RonHeg/PostAlertBaseStationMFG/README.md

# PostAlertBaseStationMFG
 PostAlert IoT Base station Documentation for manufacturing
