RonHeg/PostAlertBaseStationMFG/PostAlertBaseStationMFG/README.md

# PostAlertBaseStationMFG
 PostAlert IoT Base station Documentation for manufacturing
 PCB Gerber files are in the gerber_to_order folder
 mechanical drawings are: light pipe, base unit enclosure cutouts, front panel, base station assembly
