RonHeg/PostAlertBaseStationMFG/012024-LBL.pdf

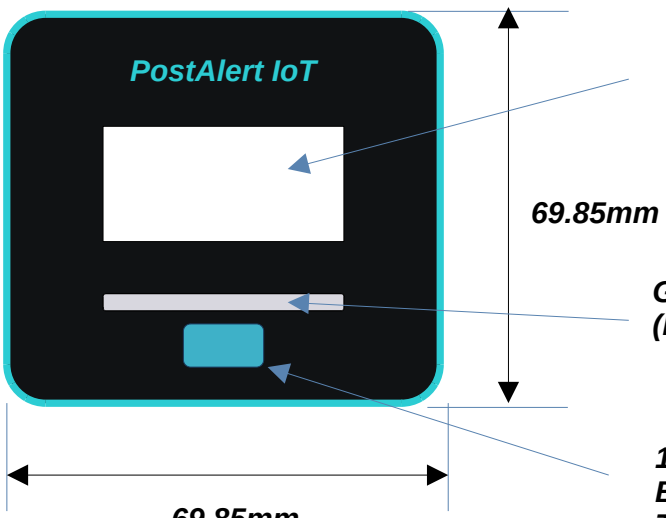
[picture p1: figure]
PostAlert IoT

Overlay attaches to top of :

New Age Enclosures: Standard Router Cube SXX-303010-XXX.

Notes:
Material: Glossy 0.2mm, PET

Transparent area: OLED display. The yellow part is a transparent clear window.

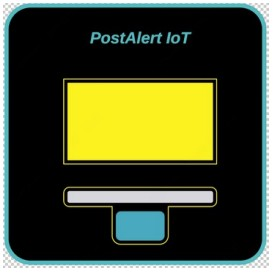
[picture p2: figure]

Grayed out area: 50% transparency. (Multi-colored LED for status)

Blacked out behind area: has a push switch mounted on the PCB.
Black out behind blue to keep out light from LED status.

Adhesive backing: 3M468MP.
These regions within yellow lines will have no adhesive on the Back of the panel.

The blue button is a flat-top bulged button with a height of 0.45mm.

Colors:
Aqua = Pantone 319 C (RGB 44, 204, 211 – HEX 2cccd3)
Black = Pantone 6C(RGB 16, 24, 32 – HEX 101803)
Gray = Pantone 5315 C (RGB 216, 215, 223 – HEX d8d7df)

Suggested Supplier:
LCSC Electronics (https://www.lcsc.com/)

RJ Hegler Technologies, LLC 9192 Albion Road
North Royalton, Ohio 44133 RJHeglerTech@gmail.com
Ron Hegler
440-478-1586

### PostAlert IoT Base Lable Drawing Number: 012024-LBL Revision 1.0

69.85mm

### Transparent (glossy) (OLED Display)

### Grayed out (Multi-color LED)

### 1 bulged button (height: 0.45mm) Blacked out behind To keep above LED from bleeding thru this area

### Note: Artwork in this drawing is for Reference only. Use MailBoxOverlay.odg for master

drawing.
