RonHeg/PostAlertBaseStationMFG/012024MainRegLabel.pdf

## PostAlert IoT Base Lable Drawing Number: 012024-LBL Revision 1.0

RJ Hegler Technologies, LLC 9192 Albion Road
North Royalton, Ohio 44133 RJHeglerTech@gmail.com
Ron Hegler
440-478-1586

RJ Hegler Technologies, LLC 9192 Albion Road
North Royalton, Ohio 44133 RJHeglerTech@gmail.com
Ron Hegler
440-478-1586

## Note: Artwork in this drawing is for Reference only. Actual text will be provided after

regulatory approval.

Label attaches to bottom of :

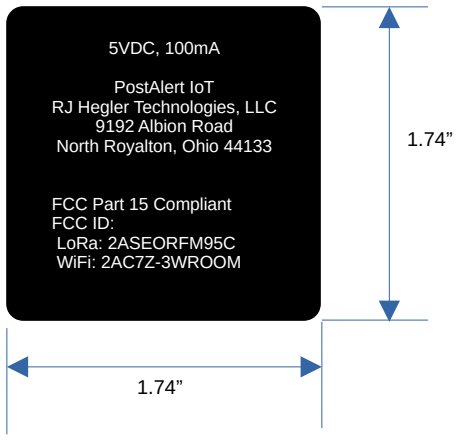
[picture p3: figure]
5VDC, 100mA; PostAlert IoT RJ Hegler Technologies, LLC 9192 Albion Road North Royalton, Ohio 44133; FCC Part 15 Compliant FCC ID: LoRa: 2ASEORFM95C WiFi: 2AC7Z-3WROOM

New Age Enclosures: Standard Router Cube SXX-303010-XXX.

Notes:
Material: Glossy 0.2mm, PET (Ref, subject to change)

Adhesive backing: 3M468MP.

### Colors

### Black = Pantone 6C (RGB 16, 24, 32 – HEX 101803) White =

### Suggested Supplier: LCSC Electronics (https://www.lcsc.com/)
