RonHeg/PostAlertBaseStationMFG/MailBoxOverlay.pdf

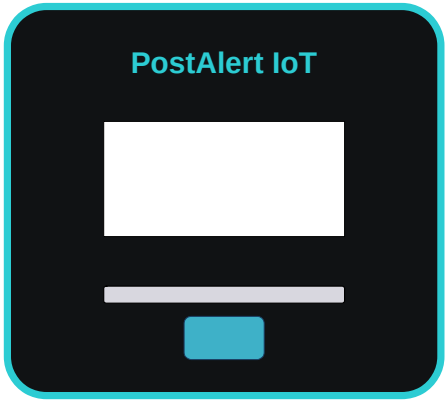
[picture p4: figure]
PostAlert IoT
