RonHeg/PostAlertBaseStationMFG/042024MainBoxAssyBOM.xls

PostAlert ToI main enclosure assembly
Item | Quantity | Description
1 | 1 | Main Enclosure Front Overlay
2 | 1 | Enclosure Front, modified
3 | 8 | M2 x 6 mm screws
4 | 1 | OLED Display
5 | 4 | M2 x 12 mm Brass Spacers
6 | 1 | Main Unit PCB Assembly
7 | 1 | Enclosure Back, modified
8 | 1 | Rear Label
9 | 4 | Screws included with enclosure
10 | 1 | PostAlert Base Light Pipe
11 | A/R | Adhesive
