RonHeg/PostAlertBaseStationMFG/PostAlertBaseStationV6.xls

Sheet: PostAlertBaseStationV6
PostAlert IoT Base Station Assy BOM
Source: | C:\RJHTech\Mailbox\PostAlertBaseStation\PostAlertBaseStationV6\PostAlertBaseStationV6.kicad_sch
Date: | 1/17/2025 12:04:40 PM
Tool: | Eeschema 7.0.10
Generator: | C:\Program Files\KiCad\7.0\bin\scripting\plugins/bom_csv_grouped_by_value.py
Component Count: | 43
Collated Components:
Item | Qty | Reference(s) | Value | Description | MFR | PN | Price(100s) | Supplier | Supplier_num
1 | REF | AE2 | Antenna | PCB Etch Antenna, 915MHz
2 | 1 | BZ1 | Piezo 3VDC 2300Hz 82dBA | Piezo Buzzers & Audio Indicators EM 3VDC 2300Hz 82dBA Continuous Top Fire | PUI Audio | AI-1223-TWT-3V-2-R | 0.817 | Mouser | 665-AI1223TWT3V2R
3 | 9 | C1, C5, C7, C9, C12, C13, C15, C16, C17 | 0.1uF | 50V .1uF X7R 0603 10% | KYOCERA AVX | KGM15BR71H104KT | 0.019 | Mouser | A581-06035C104KAT2A
4 | 5 | C2, C4, C6, C8, C10 | 10uf 6.3v | 6.3V 10uF X5R 0603 20% | KYOCERA AVX | KGM15CR50J106MT | 0.061 | Mouser | 581-KGM15CR50J106MT
5 | 1 | C3 | 11pF | MLCC - SMD/SMT 50V 11pF C0G 0603 5% | KYOCERA AVX | 06035A110JAT2A | 0.0232 | Mouser | 581-06035A110J
6 | 1 | C11 | 1uF, 16v | MLCC - SMD/SMT 16V 1uF X7R 0603 10 % | TAIYO YUDEN | MSASE168SB7105KTNA01 | 0.073 | Mouser | 963-MSASE168SB7105KT
7 | 1 | C19 | DNP | Multilayer Ceramic Capacitors MLCC - SMD/SMT 50V 1.6pF C0G 0603 0 .25pF | KYOCERA AVX | 06035A1R6CAT2A | 0.0232 | Digikey | 581-06035A1R6CAT2A
8 | 1 | D1 | NeoPixel_THT | NeoPixel Nano 2020 RGB LEDs - 10-pack - WS2812B | Adafruit | 4684 | 0.395 | Mouser | 485-4684
9 | 3 | D2, D3, D4 | 5v | ESD Protection Diodes / TVS Diodes Chip Guard 0603 5 Volts | Bourns | CG0603MLC-05LE | 0.164 | Mouser | 652-CG0603MLC-05LE
10 | 1 | DISP1 | 1.54" OLED | 1.54 Inch OLED I2C IIC Display Module, 128x64 Pixel SSD1309 Driver Self-Luminous OLED | MELIFE Store | 12864 | 6.63 | Amazon | 701715529748
11 | 1 | J1 | Conn_01x04_Socket | Headers & Wire Housings 4 PIN SIL VERTICAL SOCKET GOLD+TIN | Harwin | M20-7820442 | 0.65 | Mouser | 855-M20-7820442
12 | 1 | J2 | ESP-Prog | Connector Header Surface Mount 6 position 0.050" (1.27mm) | Amphenol ICC (FCI) | 20021121-00006C4LF | 0.4948 | Digikey | 609-3693-1-ND
13 | 1 | J5 | USB_B_Micro | CONN RCPT USB2.0 MICRO B SMD R/A | Amphenol ICC (FCI) | 10118192-0002LF | 0.3055 | Digikey | 609-5379-1-ND
14 | 1 | L1 | 36nH | FIXED IND 36NH 910MA 0.200OHM SMD | Murata | LQW18AN36NJ80D | $0.108 | Mouseer | 81-LQW18AN36NJ80D
15 | 1 | Q2 | MMBT3904 | TRANS NPN 40V 0.2A SOT23 | Micro Commercial Co | MMBT3904-TP | 0.0369 | Digikey | MMBT3904TPMSCT-ND
16 | 7 | R1, R2, R3, R4, R5, R6, R7 | 10k | Thin Film Resistors - SMD CHIP RESISTOR Precision | Bourns | CRT0603-FZ-1002ELF | 0.023 | Mouser | 652-CRT0603FZ1002ELF
17 | 1 | R8 | 8.2k | Thick Film Resistors - SMD D11/CRCW0603 100 8K2 1% | Vishay / Dale | CRCW06038K20FKEC | 0.014 | Mouser | 71-CRCW06038K20FKEC
18 | 1 | SW1 | SW_Push | Tactile Switches 6 x 6 mm, 7.3 mm Act Height, 160 gf, Black, Long Crimped, Through Hole, SPST, | CUI Devices | TS01-66-73-BK-160-D | 0.107 | Mouser | 179-TS016673BK160D
19 | 2 | SW2, SW3 | SW_Push | Tactile Switches 6 x 7.4 mm 4.3 mm 100 gf Black Right Angle Through Hole SPST | CUI Devices | TS11-674-43-BK-100-RA-D | 0.123 | Mouser | 179-TS1167443100RAD
20 | 1 | U1 | ESP32-C3 | RF TXRX MODULE BT PCB TRACE SMD | Espressif Systems | ESP32-C3-MINI-1-H4 | 1.9 | Digikey | 1965-ESP32-C3-MINI-1-H4TR-ND
21 | 1 | U2 | RFM95W-915S2 | RF TXRX MODULE ISM<1GHZ WIRE ANT | Hope RF | RFM95CW-915S2 / COM-18085 | 6.50 / 9.95 / 4.52 | Arduino.com / Sparkfun / Aliexpress | RFM95CW-915S2
22 | 1 | U3 | AZ1117-3.3 | LDO Voltage Regulators LDO BJT HiCurr | Diodes Incorporated | AZ1117H-3.3TRG1 | 0.781 | Mouser | 621-AZ1117H-3.3TRG1
* |  | Not Yet Evaluated | lora1276-C1-915MHz | G-NiceRF lora1276-C1-915MHz | https://www.lcsc.com/product-detail/LoRa-Modules_G-NiceRF-lora1276-C1-915MHz_C3001531.html

Sheet: Base Station Assy
Base Station Final
Item | Qty | Description | MFR | PN | Price(100s) | Supplier | Supplier_num
1 | 1 | Overlay, Front | DWG | 012021-OVL |  | LCSC
2 | 1 | Enclosure | New Age Enclosures | S3A-30310
3 | 8 | M2 x 6mm screw |  | B07Y5BNR4J |  | amazon | https://www.amazon.com/dp/B07YS8NR4J?ref=ppx_yo2ov_dt_b_fed_asin_title&th=1
4 | 1 | OLED Display |  | 012024-OLD |  | amazon | https://www.amazon.com/dp/B0BFD4X6YV?ref=ppx_yo2ov_dt_b_fed_asin_title&th=1
5 | 4 | M2 x 12mm standoff |  | B0BHHDXVXZ |  | amazon | https://www.amazon.com/dp/B0BHHDXVXZ?ref=ppx_yo2ov_dt_b_fed_asin_title&th=1
6 | 1 | PostAlert IoT PCB |  | 012027-PCB (page 1)
7 | 4 | #6 screws |  | included w/item 2
