RonHeg/PostAlertBaseStationMFG/BaseStationAssy.dxf

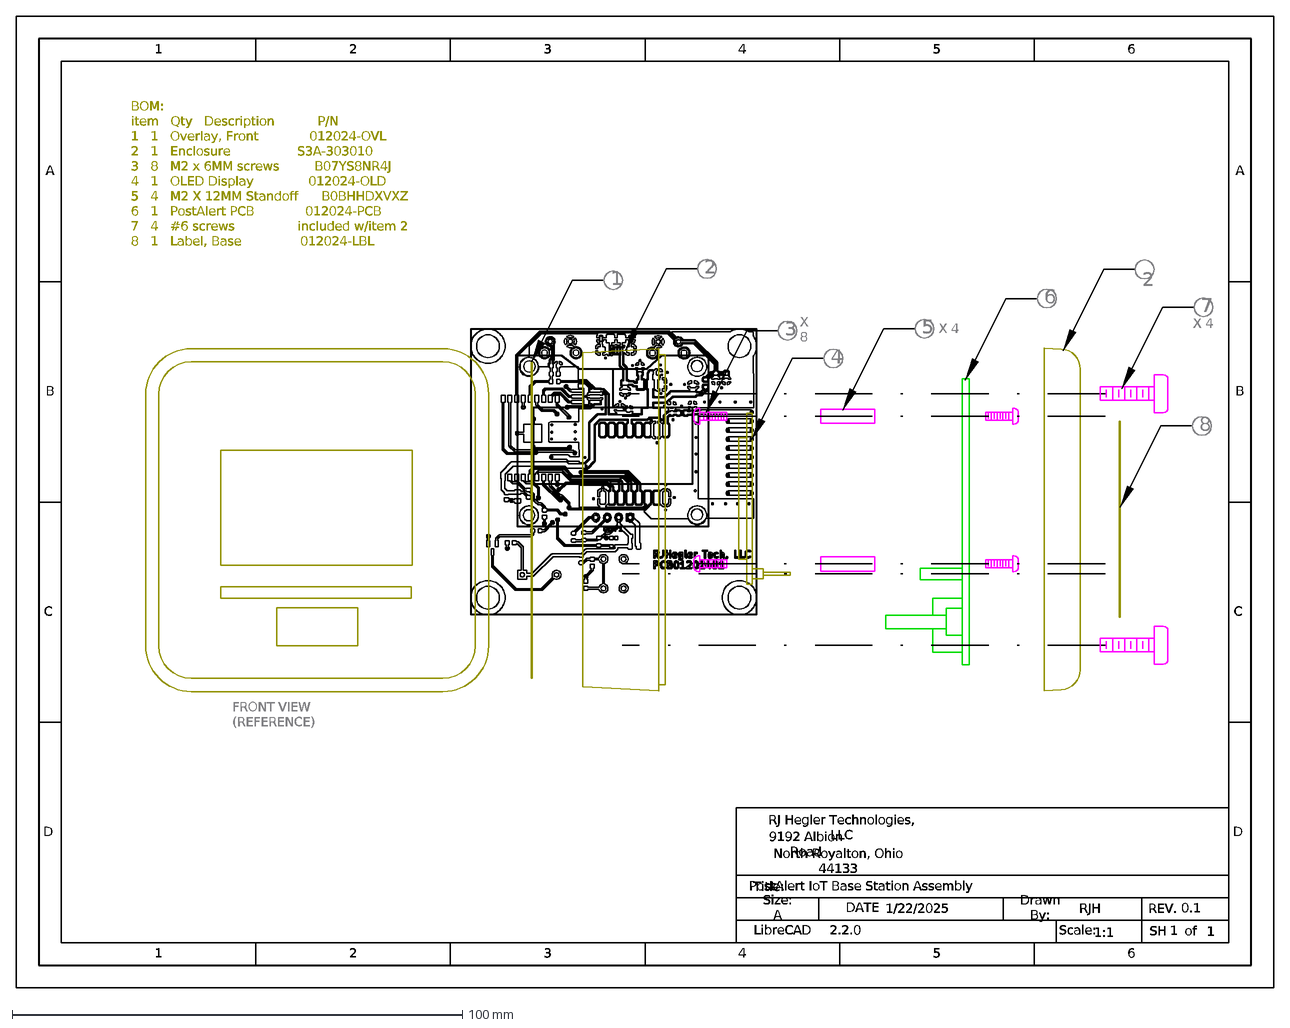
[picture p5: CAD file, 2025-02-27]
BaseStationAssy.dxf
A
B
C
D
1
2
3
4
5
6
SH
REV.
of
0.1
LibreCAD
DATE
Size: A
Title:
RJ Hegler Technologies, LLC
9192 Albion Road
North Royalton, Ohio 44133
Drawn By:
Scale:
1/22/2025
RJH
1:1
2.2.0
7
X 8
X 4
FRONT VIEW (REFERENCE)
PostAlert IoT Base Station Assembly
BOM: item Qty Description P/N 1 1 Overlay, Front 012024-OVL 2 1 Enclosure S3A-303010 3 8 M2 x 6MM screws B07YS8NR4J 4 1 OLED Display 012024-OLD 5 4 M2 X 12MM St
8
