RonHeg/PostAlertBaseStationMFG/012024MainEnclosureCutout.dxf

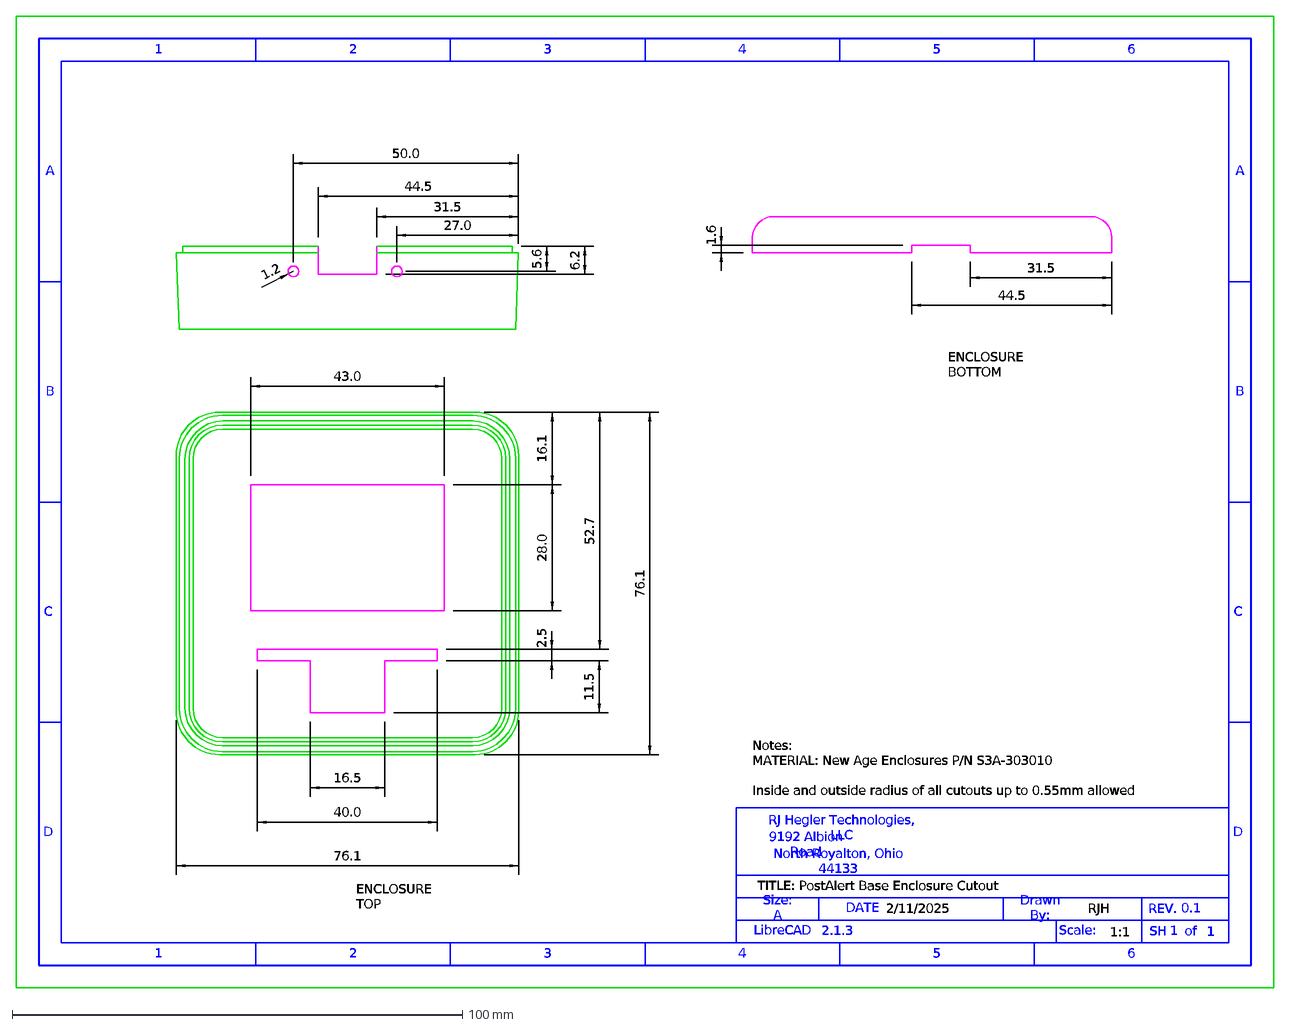
[picture p6: CAD file, 2025-02-27]
012024MainEnclosureCutout.dxf
D
1
2
3
4
5
6
A
B
C
SH
REV.
of
0.1
LibreCAD
2.1.3
DATE
Size: A
Drawn By:
Scale:
2/11/2025
RJH
1:1
RJ Hegler Technologies, LLC
9192 Albion Road
North Royalton, Ohio 44133
52.7
16.1
28.0
43.0
5.6
6.2
44.5
31.5
27.0
50.0
1.2
2.5
11.5
16.5
40.0
76.1
1.6
TITLE: PostAlert Base Enclosure Cutout
Notes: MATERIAL: New Age Enclosures P/N S3A-303010 Inside and outside radius of all cutouts up to 0.55mm allowed
ENCLOSURE TOP
ENCLOSURE BOTTOM
