RonHeg/PostAlertBaseStationMFG/042024LightPipe.dxf

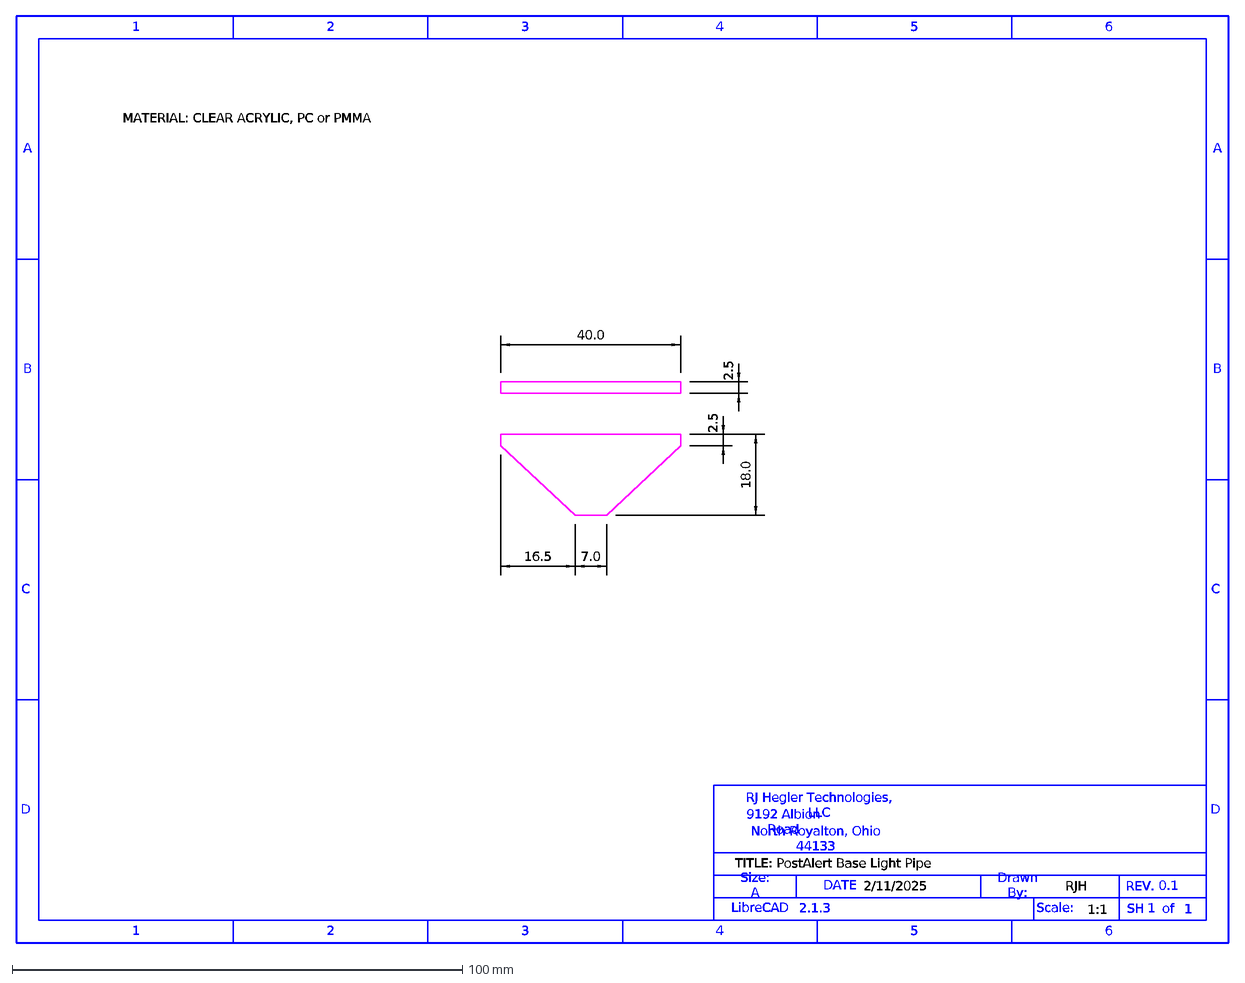
[picture p7: CAD file, 2025-02-27]
042024LightPipe.dxf
D
1
2
3
4
5
6
A
B
C
SH
REV.
of
0.1
LibreCAD
2.1.3
DATE
Size: A
Drawn By:
Scale:
2/11/2025
RJH
1:1
RJ Hegler Technologies, LLC
9192 Albion Road
North Royalton, Ohio 44133
TITLE: PostAlert Base Light Pipe
2.5
18.0
40.0
16.5
7.0
MATERIAL: CLEAR ACRYLIC, PC or PMMA
