RonHeg/PostAlertBaseStationMFG/012024-Light_Pipe.pdf

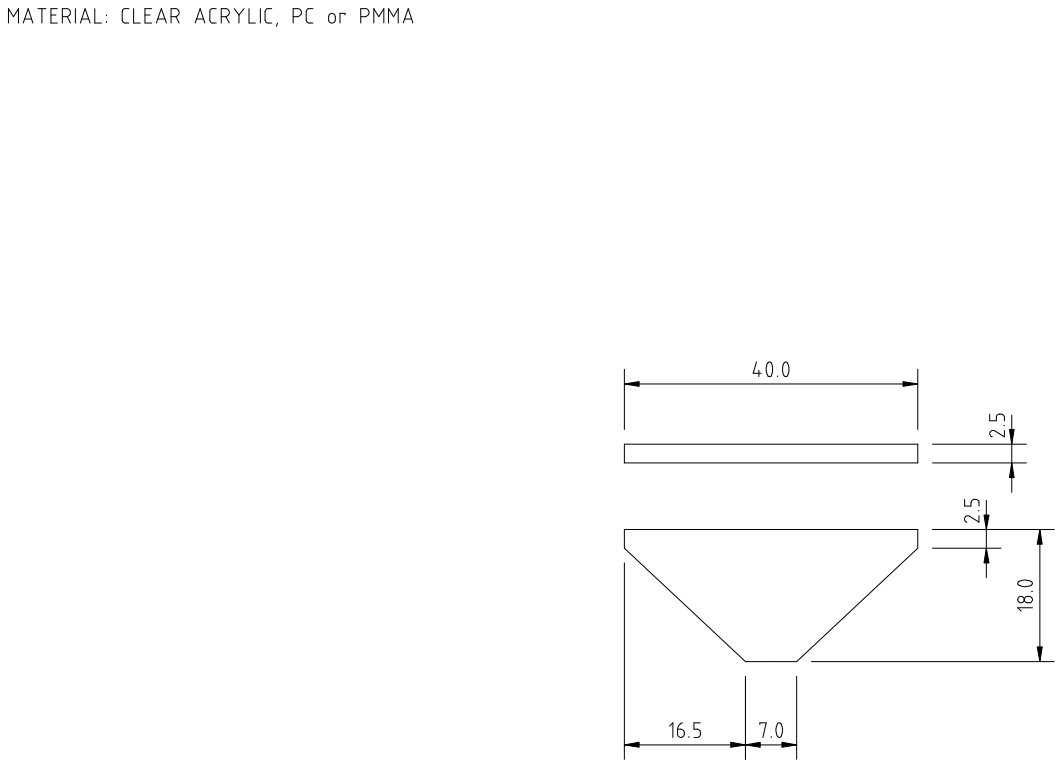
[picture p8: page 1]
