RonHeg/PostAlertBaseStationMFG/012024-MOD_Base Unit Enclosure Cutouts.pdf

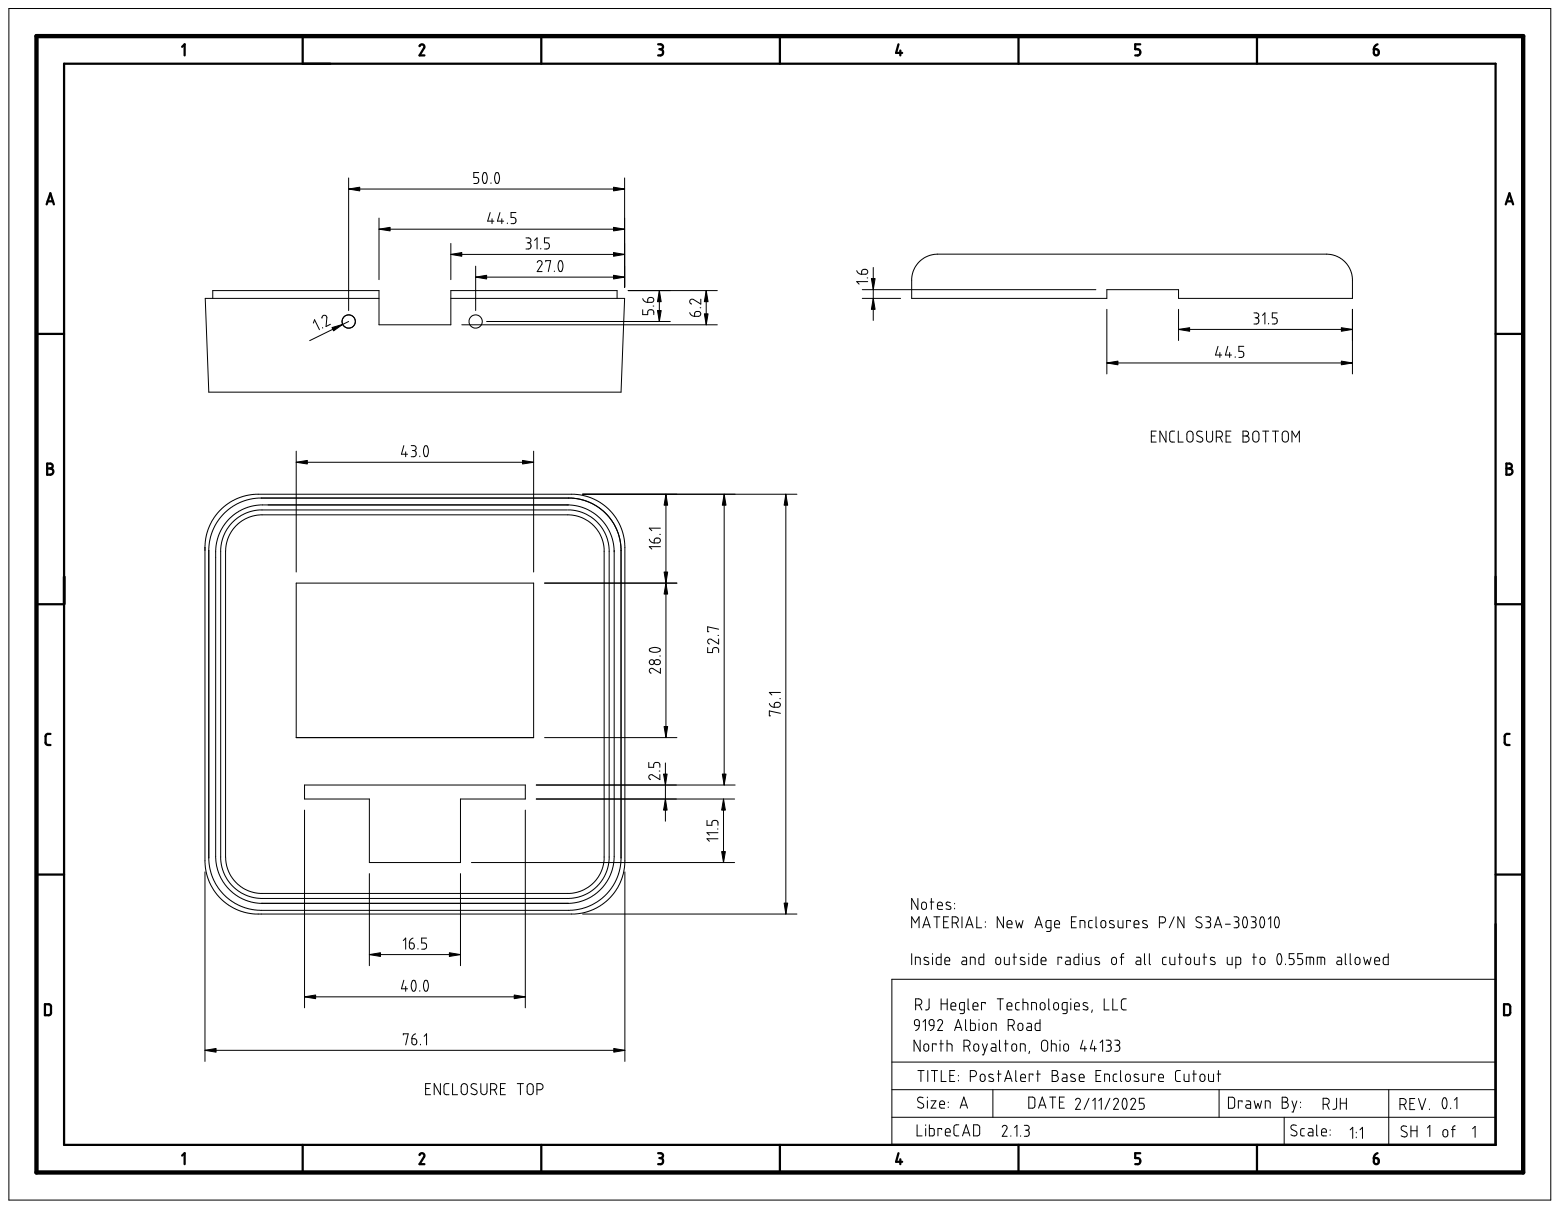
[picture p9: page 1]
