RonHeg/PostAlertBaseStationMFG/PostAlert Base Station PCB Fab Dwg.pdf

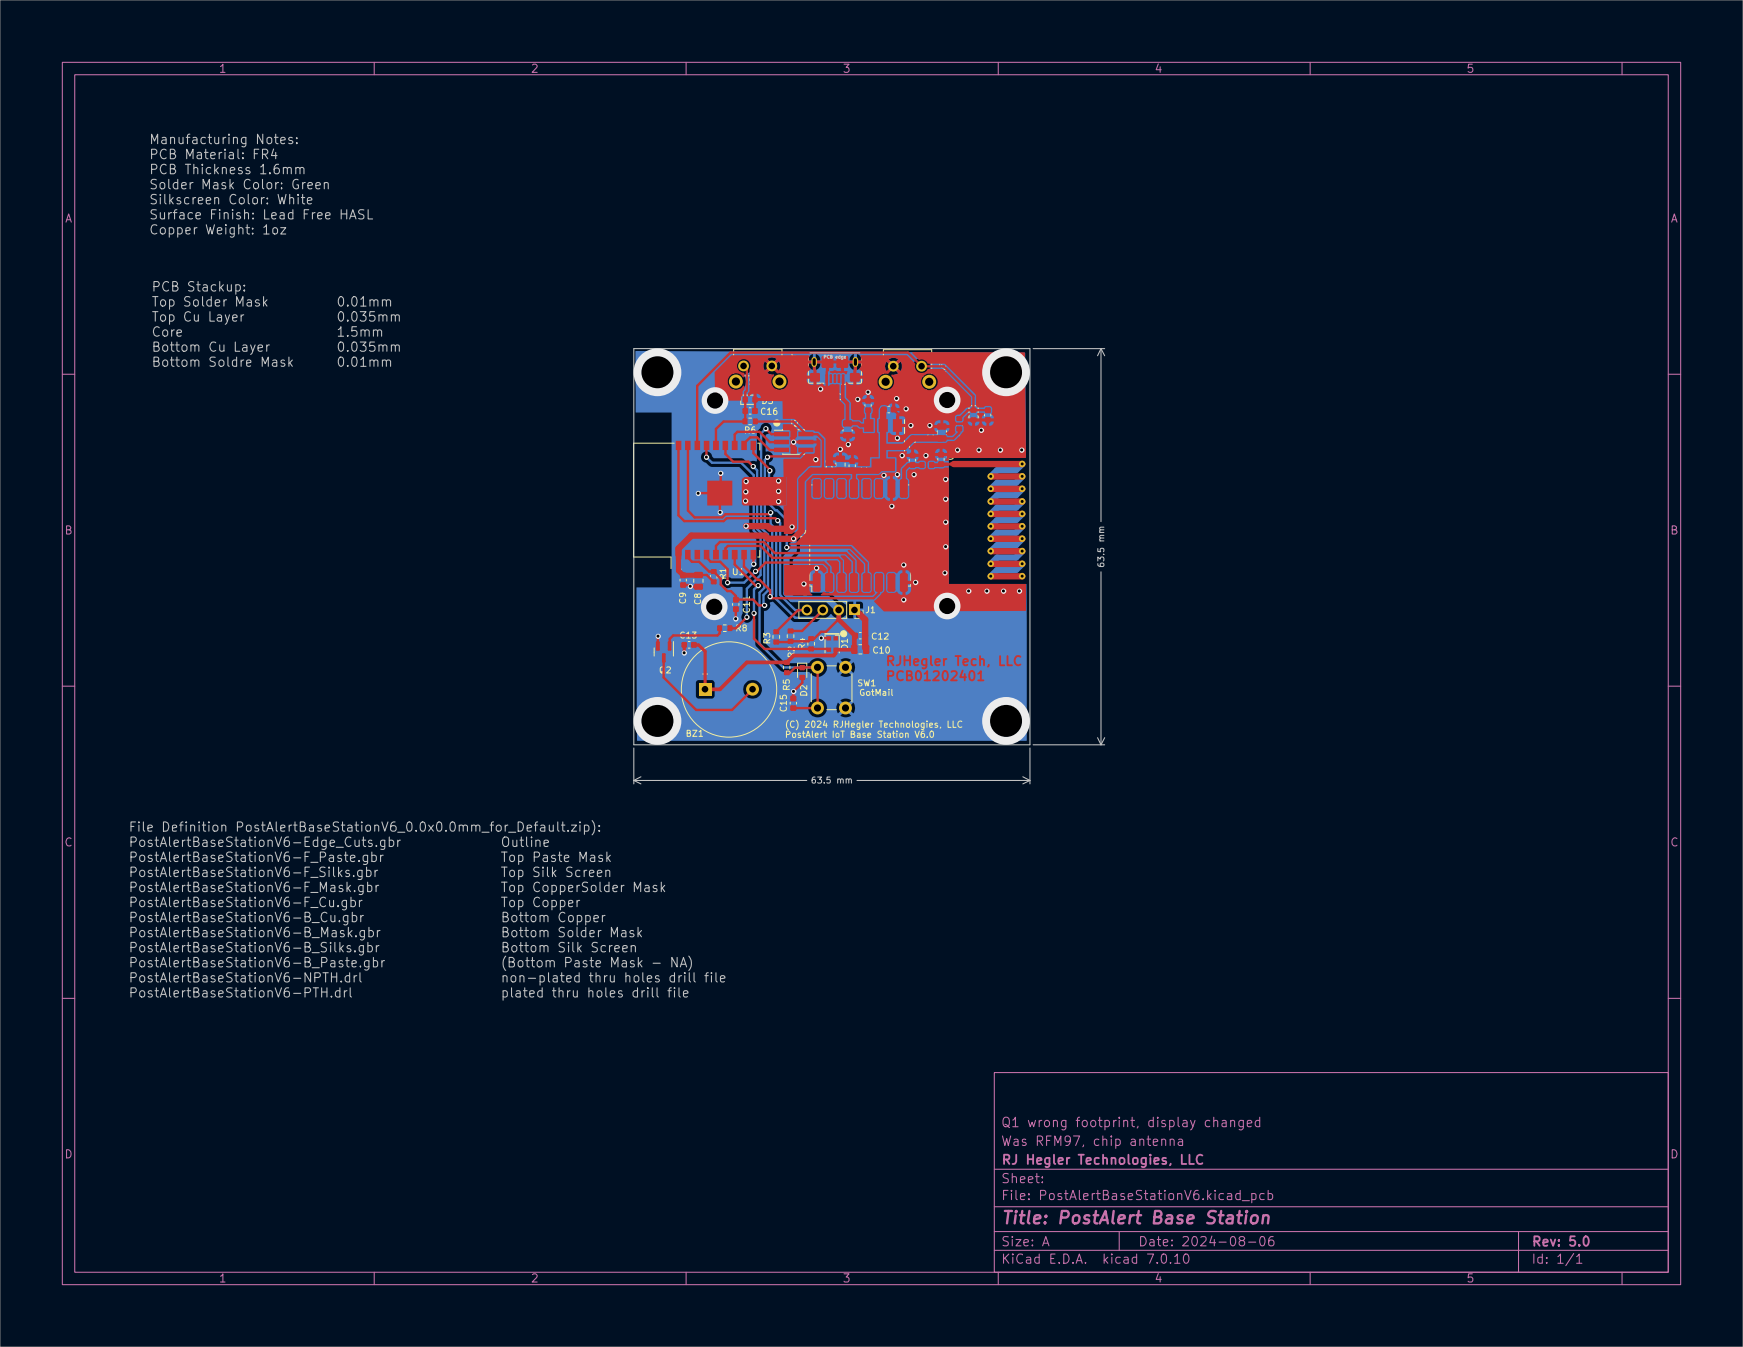
[picture p10: page 1]
