RonHeg/PostAlertBaseStationMFG/KiCad/PostAlertBaseStationV6.kicad_pcb

## KiCad design KiCad/PostAlertBaseStationV6.kicad_pcb (2025-02-27)

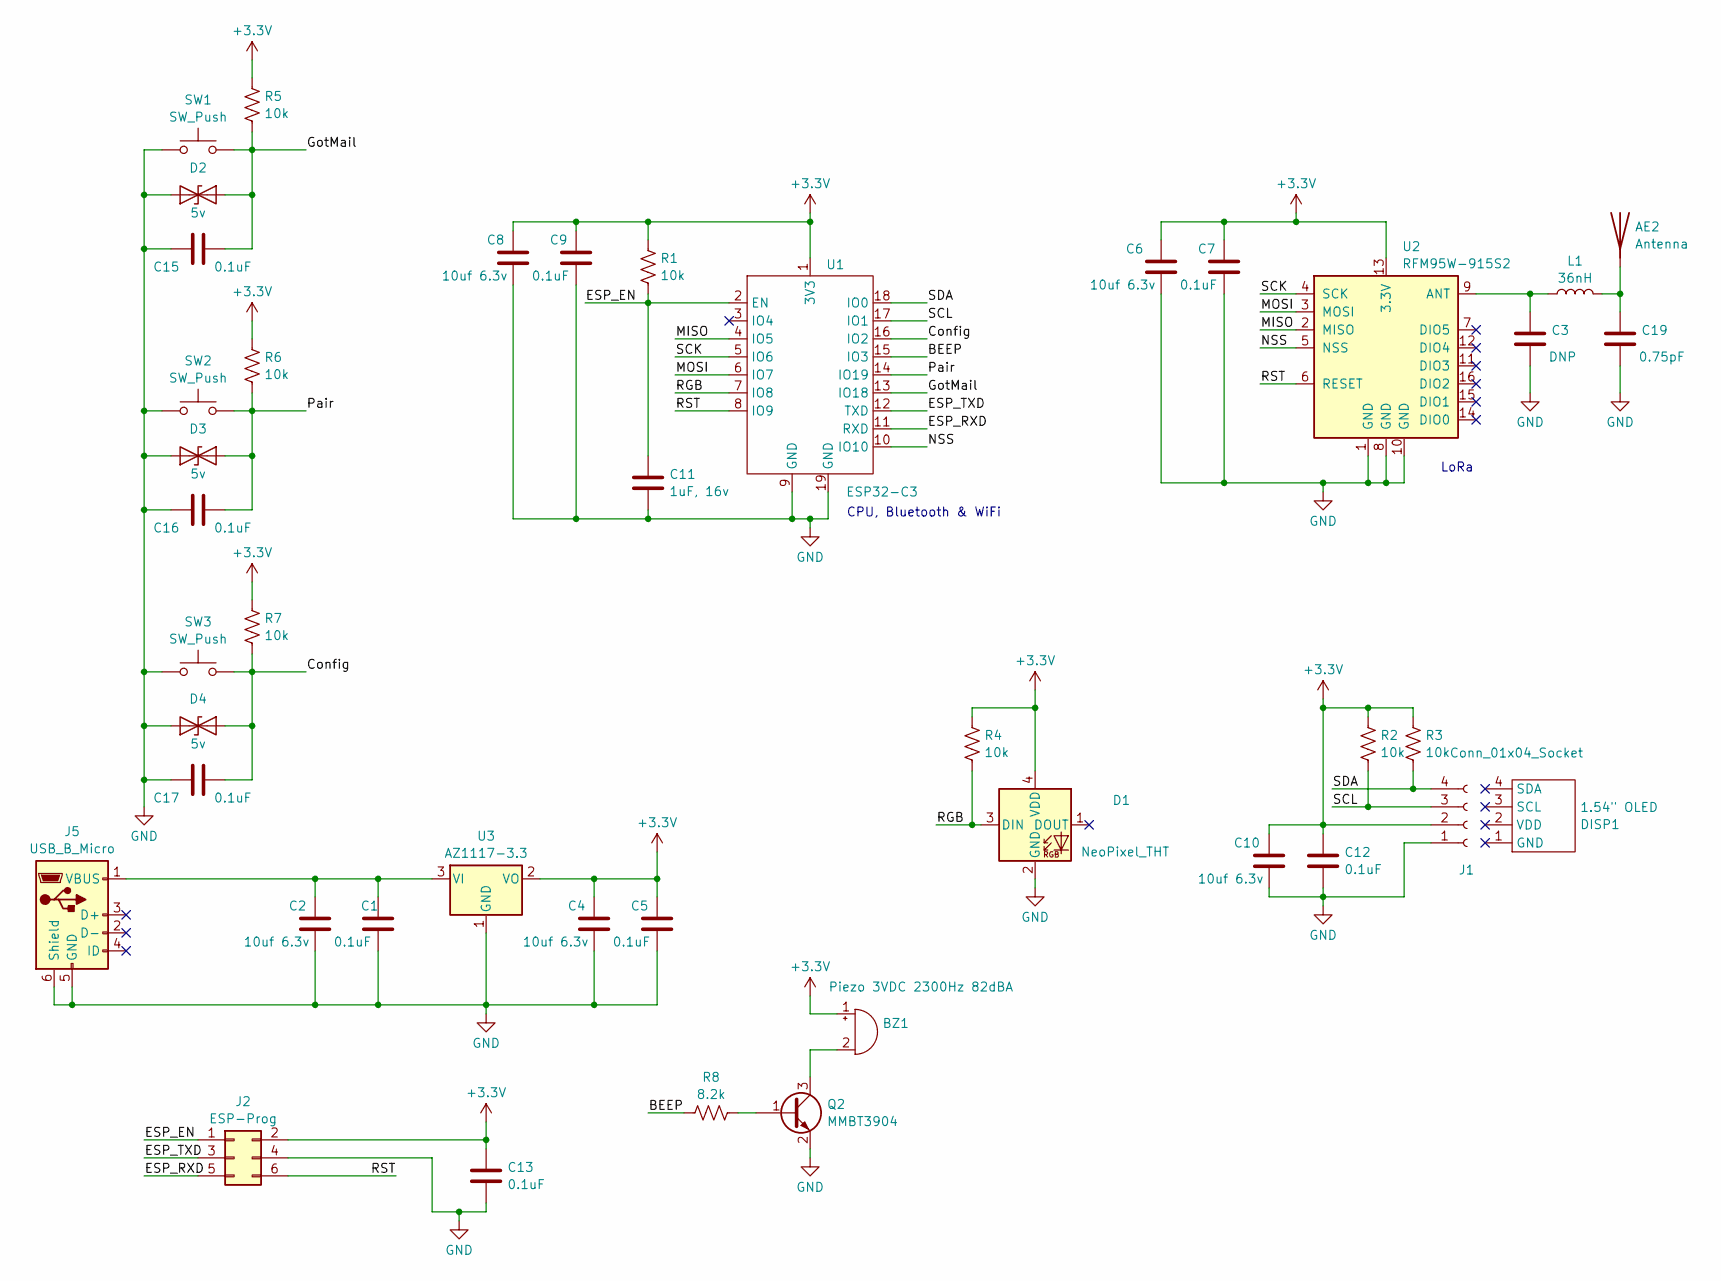
[picture p11: schematic PostAlertBaseStationV6.kicad_sch, PostAlertBase Station]

Parts:
AE2: Antenna; Texas_SWRA416_868MHz_915MHz
BZ1: Piezo 3VDC 2300Hz 82dBA; Buzzer_15x7.5RM7.6
C1, C5, C7, C9, C12, C13, C15, C16, C17: 0.1uF; C_0603_1608Metric
C2, C4, C6, C8, C10: 10uf 6.3v; C_0805_2012Metric
C3: DNP; C_0603_1608Metric
C11: 1uF, 16v; C_0603_1608Metric
C19: 0.75pF; C_0603_1608Metric
D1: NeoPixel_THT; LED_WS2812B-2020_PLCC4_2.0x2.0mm
D2, D3, D4: 5v; D_0603_1608Metric
DISP1: 1.54" OLED; DISPLAY-OLED-1.54_IIC_1
J1: Conn_01x04_Socket; PinSocket_1x04_P2.54mm_Vertical
J2: ESP-Prog; PinHeader_2x03_P1.27mm_Vertical_SMD
J5: USB_B_Micro; USB_Micro-B_Amphenol_10118193-0002LF_Horizontal
L1: 36nH; L_0603_1608Metric
Q2: MMBT3904; SOT-23
R1, R2, R3, R4, R5, R6, R7: 10k; R_0603_1608Metric
R8: 8.2k; R_0603_1608Metric
SW1: SW_Push; SW_PUSH_6mm
SW2, SW3: SW_Push; SW_Tactile_SKHH_Angled
U1: ESP32-C3; ESP-WROOM-02
U2: RFM95W-915S2; HOPERF_RFM9XW_SMD
U3: AZ1117-3.3; SOT-223-3_TabPin2

Connections:
+3.3V: BZ1.1 (+), C4.1, C5.1, C6.1, C7.1, C8.1, C9.1, C10.1, C12.1, C13.1, D1.4 (VDD), J1.2, J2.2, R1.1, R2.1, R3.1, R4.1, R5.1, R6.1, R7.1, U1.1 (3V3), U2.13 (3.3V), U3.2 (VO)
/BEEP: R8.1, U1.15 (IO3)
/Config: C17.2, D4.1 (A1), R7.2, SW3.2, U1.16 (IO2)
/ESP_EN: C11.1, J2.1, R1.2, U1.2 (EN)
/ESP_RXD: J2.5, U1.11 (RXD)
/ESP_TXD: J2.3, U1.12 (TXD)
/GotMail: C15.2, D2.1 (A1), R5.2, SW1.2, U1.13 (IO18)
/MISO: U1.4 (IO5), U2.2 (MISO)
/MOSI: U1.6 (IO7), U2.3 (MOSI)
/NSS: U1.10 (IO10), U2.5 (NSS)
/Pair: C16.2, D3.1 (A1), R6.2, SW2.1, U1.14 (IO19)
/RGB: D1.3 (DIN), R4.2, U1.7 (IO8)
/RST: J2.6, U1.8 (IO9), U2.6 (RESET)
/SCK: U1.5 (IO6), U2.4 (SCK)
/SCL: J1.3, R2.2, U1.17 (IO1)
/SDA: J1.4, R3.2, U1.18 (IO0)
GND: C1.2, C2.2, C3.2, C4.2, C5.2, C6.2, C7.2, C8.2, C9.2, C10.2, C11.2, C12.2, C13.2, C15.1, C16.1, C17.1, C19.2, D1.2 (GND), D2.2 (A2), D3.2 (A2), D4.2 (A2), J1.1, J2.4, J5.5 (GND), J5.6 (Shield), Q2.2 (E), SW1.1, SW2.2, SW3.1, U1.9 (GND), U1.19 (GND), U2.1 (GND), U2.8 (GND), U2.10 (GND), U3.1 (GND)
unnamed: AE2.1 (A), C19.1, L1.2
unnamed: BZ1.2 (-), Q2.3 (C)
unnamed: C1.1, C2.1, J5.1 (VBUS), U3.3 (VI)
unnamed: Q2.1 (B), R8.2
unnamed: C3.1, L1.1, U2.9 (ANT)

Notes on the sheet:
CPU, Bluetooth & WiFi
LoRa

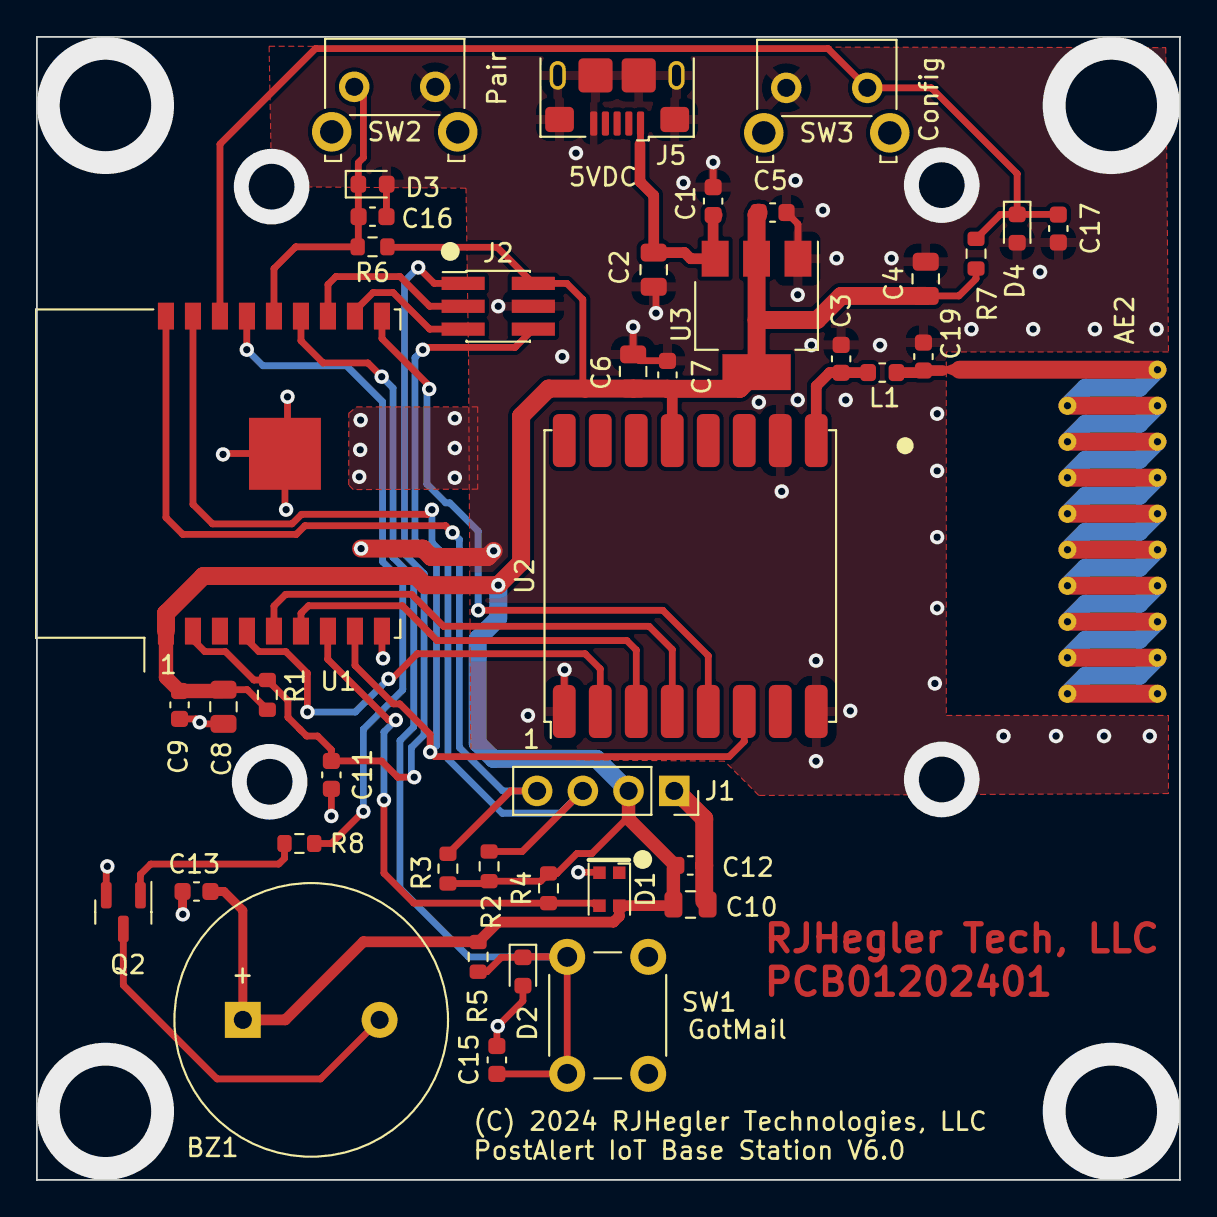
[picture p12: board PostAlertBaseStationV6.kicad_pcb from above]

Board: 2 copper layers, 63.5 x 63.5 mm, 42 parts (0 on the bottom side), 22 nets.
