RonHeg/PostAlertBaseStationMFG/Test Documentation/PostAlert IoT Test Report.odt

Tests performed 2/28/2025 RJHegler scans witnessed by Jeff Shandor

EMI testing performed using a HP Spectrum Analyzer:

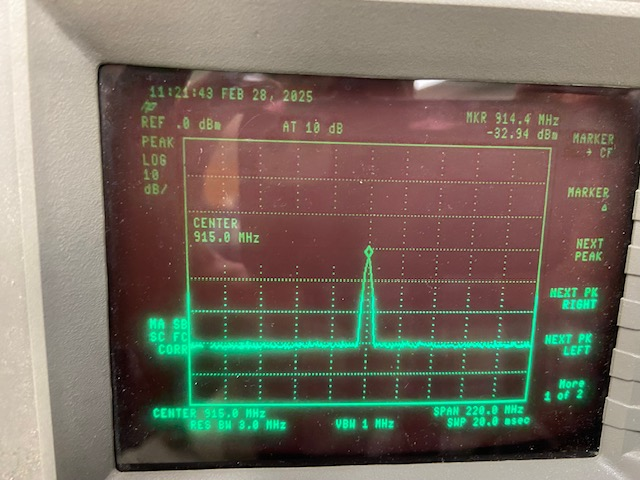
[picture p13: figure]

LoRa send and response from PostAlert: near field magnetic probe

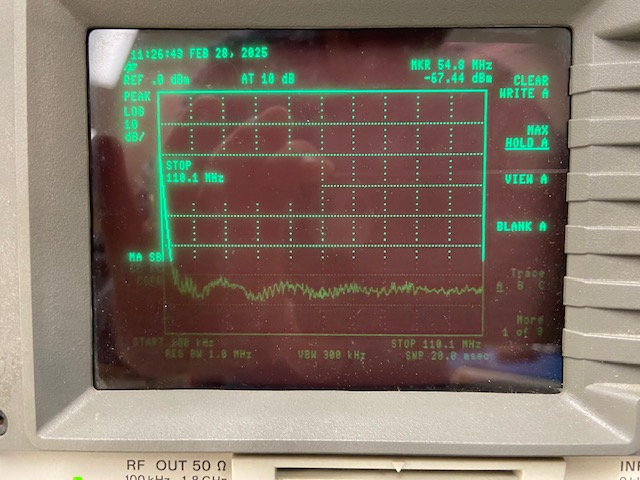
[picture p14: figure]

Magnetic field probe placed near the OLED display of the base unit.

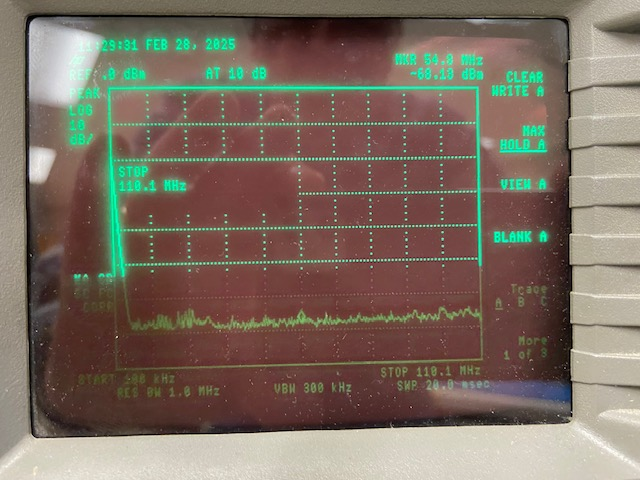
[picture p15: figure]

E-field probe placed near the OLED display of the base unit.

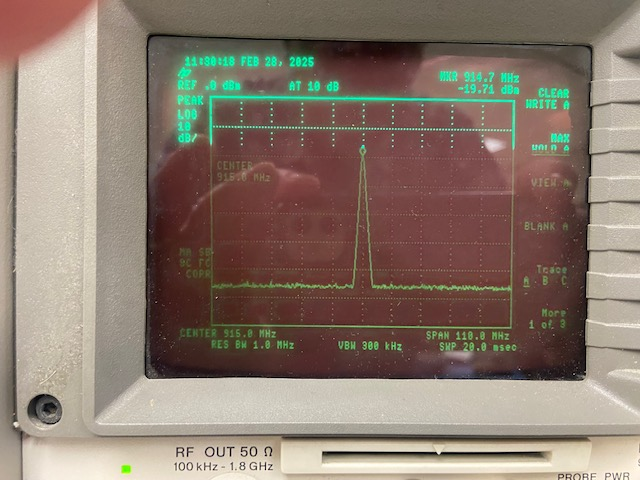
[picture p16: figure]

E-Field probe showing LoRa send and response.
