RonHeg/PostAlertBaseStationMFG/(notices)

Notices in the files:
KiCad/PostAlertBaseStationV6.kicad_pcb:
(C) 2024 RJHegler Technologies, LLC
